iwonder77/dino-nameplate/src/App.cpp

#include "App.h"
#include "Config.h"

bool App::setup() {
  pinMode(Config::Audio::AUDIO_BUSY, INPUT);
  pinMode(Config::Audio::AUDIO_OUT, OUTPUT);
  digitalWrite(Config::Audio::AUDIO_OUT, LOW);

  pinMode(Config::BrightSign::LEFT_BRIGHTSIGN_OUT_PIN, OUTPUT);
  pinMode(Config::BrightSign::RIGHT_BRIGHTSIGN_OUT_PIN, OUTPUT);
  digitalWrite(Config::BrightSign::LEFT_BRIGHTSIGN_OUT_PIN, HIGH);
  digitalWrite(Config::BrightSign::RIGHT_BRIGHTSIGN_OUT_PIN, HIGH);

  if (!mpr121.begin()) {
    Serial.print("MPR121 not found, check wiring");
    return false;
  }

  delay(1000);

  mpr121.verifyRegisters();

  if (state == Config::AppState::DEBUG) {
    Serial.println("=== FULL ELECTRODE READINGS ===");
    Serial.println("Electrode, Filtered, Baseline, Delta");
  }
  return true;
}

void App::loopOnce() {
  switch (state) {
  case Config::AppState::DEBUG:
    runDebug();
    break;
  case Config::AppState::RUN:
    run();
    break;
  case Config::AppState::ERROR_RECOVERY:
    // TODO: implement recover() method
    break;
  default:
    break;
  }
}

void App::runDebug() {
  for (uint8_t i = 0; i < Config::Touch::NUM_ELECTRODES; i++) {
    mpr121.dumpCapData(i);
  }
  Serial.println();
  delay(10);
}

// NOTE: query MPR121's touched() method only when system is in IDLE or in
// COOLDOWN (not playing sounds) to avoid speaker interference messing with
// baseline tracking and delta updates
void App::run() {
  bool isPlaying = (digitalRead(Config::Audio::AUDIO_BUSY) == LOW);

  switch (currentRunState) {
  case RunState::IDLE:
    currTouched = mpr121.touched();
    for (uint8_t i = 0; i < Config::Touch::NUM_ELECTRODES; i++) {
      if ((currTouched & _BV(i)) && !(lastTouched & _BV(i))) {
        // if it *is* touched and *wasnt* touched before:
        // send HIGH trigger signal to DY-HV20T to play the audio file
        // take a timestamp
        // then transition state
        digitalWrite(Config::Audio::AUDIO_OUT, HIGH);
        playbackBeganAt = millis();
        currentRunState = RunState::PLAYING;

        // also send LOW signal to BrightSign
        digitalWrite(Config::BrightSign::LEFT_BRIGHTSIGN_OUT_PIN, LOW);
        digitalWrite(Config::BrightSign::RIGHT_BRIGHTSIGN_OUT_PIN, LOW);
        break;
      }
    }
    lastTouched = currTouched;
    break;
  case RunState::PLAYING:
    // wait for busy pin to assert
    if (millis() - playbackBeganAt < Config::LOW_SIGNAL_TIMEOUT_MS)
      break;
    digitalWrite(Config::Audio::AUDIO_OUT, LOW);
    digitalWrite(Config::BrightSign::LEFT_BRIGHTSIGN_OUT_PIN, HIGH);
    digitalWrite(Config::BrightSign::RIGHT_BRIGHTSIGN_OUT_PIN, HIGH);
    // safety timeout: if playback exceeds maximum expected duration, force exit
    if (millis() - playbackBeganAt > Config::Audio::AUDIO_MAX_DURATION_MS) {
      Serial.println("WARN: Playback timeout, forcing IDLE");
      currentRunState = RunState::COOLDOWN;
      playbackEndedAt = millis();
      break;
    }
    if (!isPlaying) {
      // only transition back to COOLDOWN state when sound is done playing
      currentRunState = RunState::COOLDOWN;

      Serial.println("DONE PLAYING");

      // create a timestamp when playback ended to begin cooldown period
      playbackEndedAt = millis();
    } else {
      Serial.println("PLAYING");
    }
    break;
  case RunState::COOLDOWN:
    // allow MPR121 to take readings/update delta during cooldown period but
    // don't do anything with them, this is to ensure stale readings from last
    // transition and ema filter are updated
    Serial.println("cooling down!");
    currTouched = mpr121.touched();
    lastTouched = currTouched;
    if (millis() - playbackEndedAt >= Config::Audio::AUDIO_END_COOLDOWN_MS) {
      currentRunState = RunState::IDLE;
    }
    break;
  }

  // calm lil delay to prevent overwhelming mcu
  delay(10);
}
