iwonder77/dino-nameplate/(commit log)

2025-12-09 modify electrode num and audio busy pin constants
2025-12-10 add one output pin for BrightSign GPIO
2025-12-10 add logic to send digital LOW to BrightSign via new pin for a certain time interval
2025-12-10 add new LOW signal timeout constant, and a new audio out pin for sending a low signal
2025-12-15 modify audio out pins to send digital HIGH signals for the small npn BJT circuit I created, ensuring the IOx pin of the DY-HV20T is pulled to ground only when this HIGH signal is sent, and stays pull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
2026-01-26 include a 10s delay on startup to allow some time for cabinet to close and then calibration of MPR121 to begin (in the installation, electrode wires sit up against the TV when closed, so they have to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
2026-01-26 update README to include wiring diagram and add wiring diagram files
2026-01-26 update README with mainentance notes and circuit analysis
2026-01-27 fix some erroneous comments left from previous hardware setup
    [App.cpp]
2026-01-27 update pdf of schematic
